Hushbee5/cold-gas-vertical-landing-rocket/figures/hardware/01_arac_genel.png

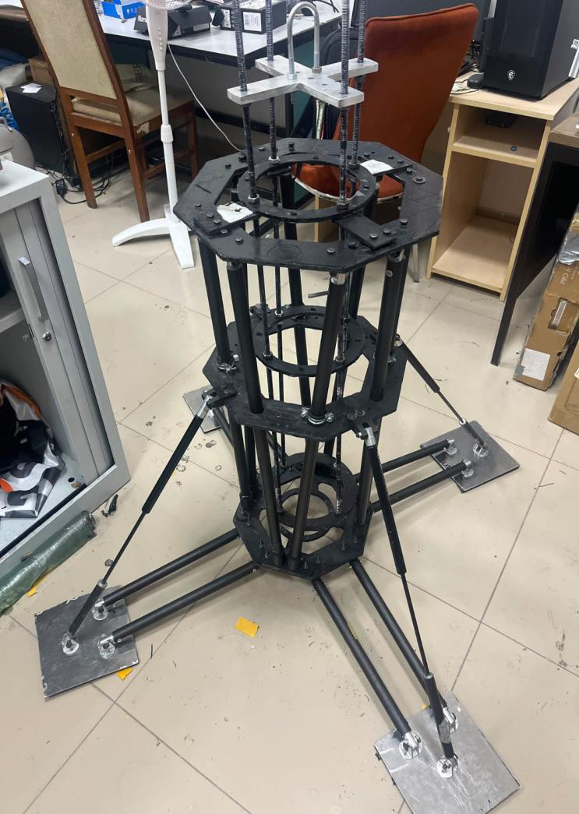
figures/hardware/01_arac_genel.png
