Hushbee5/cold-gas-vertical-landing-rocket/figures/hardware/02_sase.png

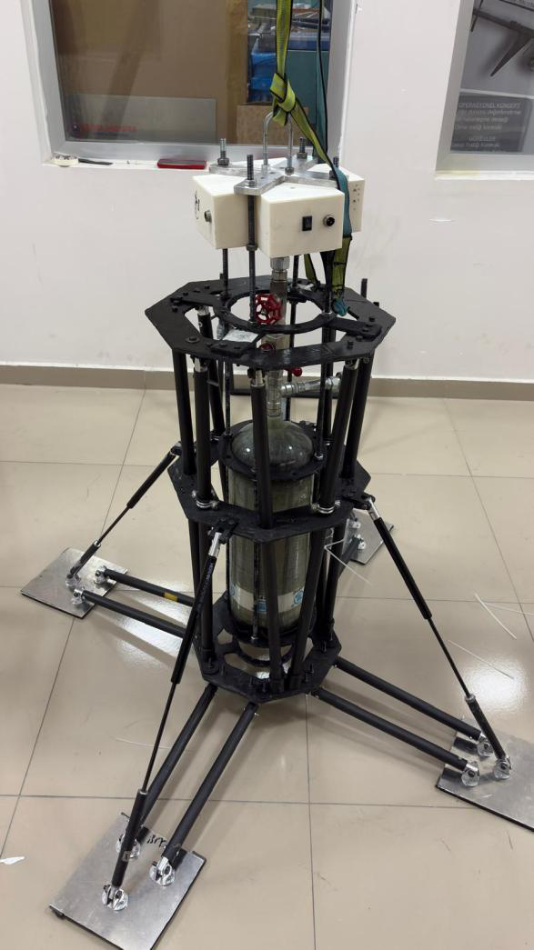
figures/hardware/02_sase.png
