Hushbee5/cold-gas-vertical-landing-rocket/figures/paper/18_bode.png

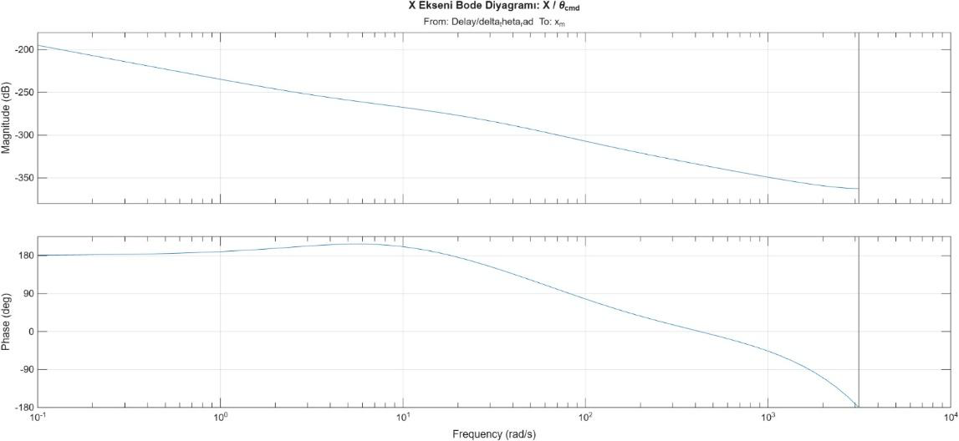
figures/paper/18_bode.png
