Hushbee5/cold-gas-vertical-landing-rocket/figures/paper/19_6dof_blok.png

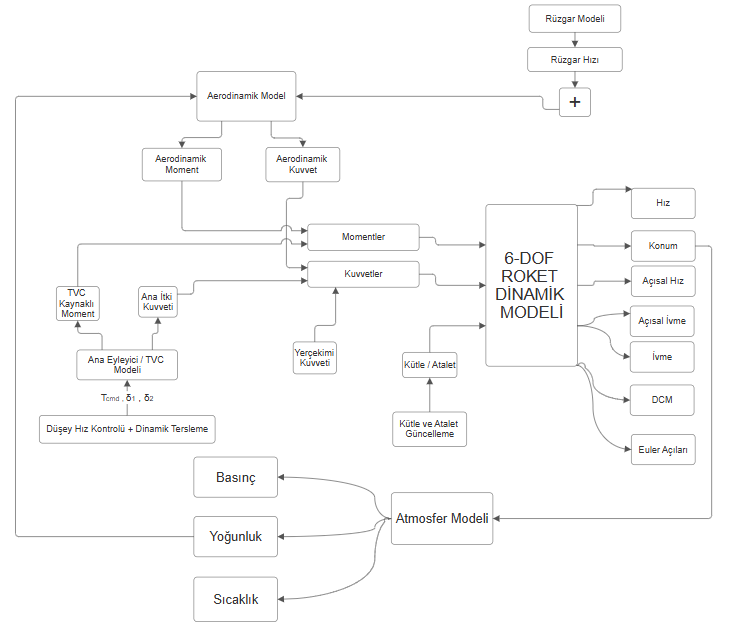
figures/paper/19_6dof_blok.png
