Hushbee5/cold-gas-vertical-landing-rocket/figures/paper/F07_dynamic_inversion.png

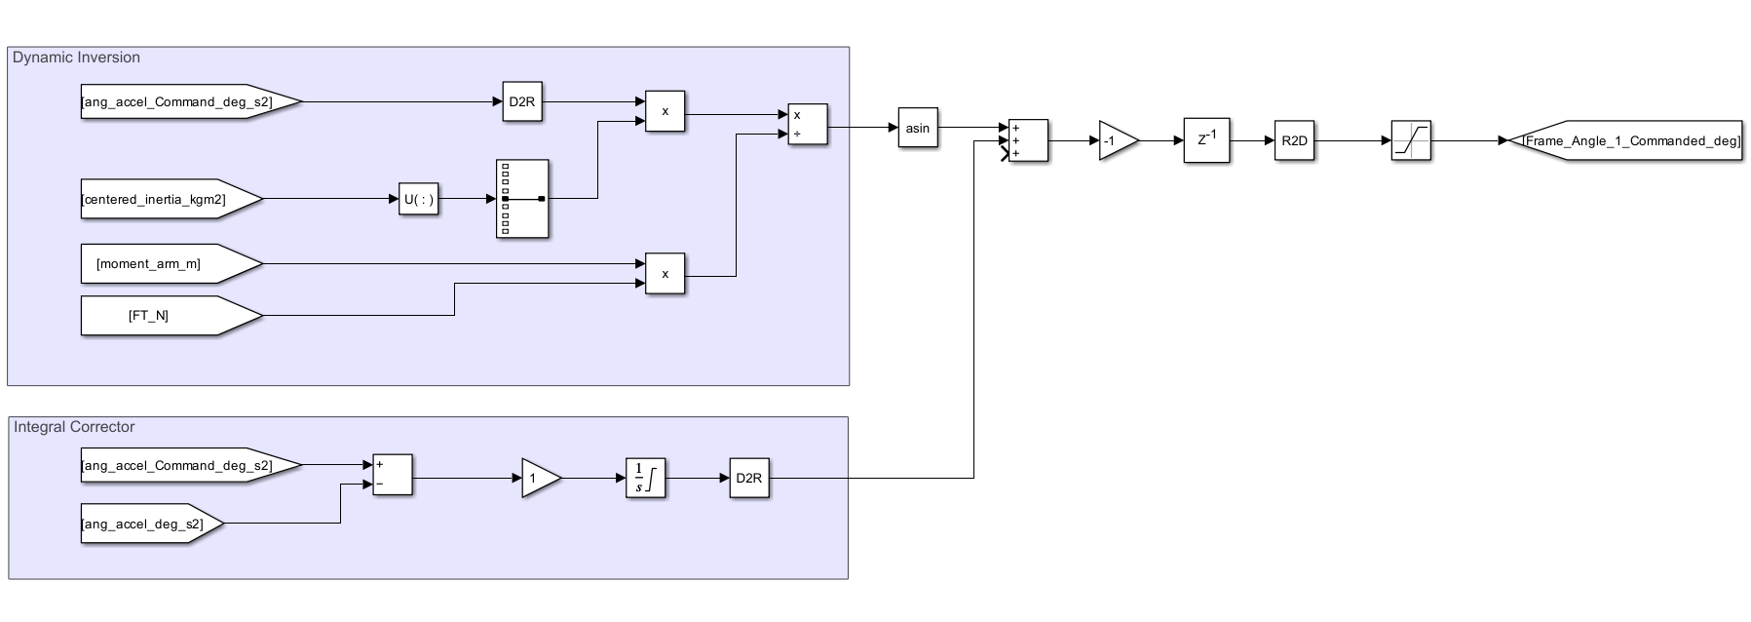
figures/paper/F07_dynamic_inversion.png
