Hushbee5/cold-gas-vertical-landing-rocket/figures/paper/F07_dynamic_inversion_hires.png

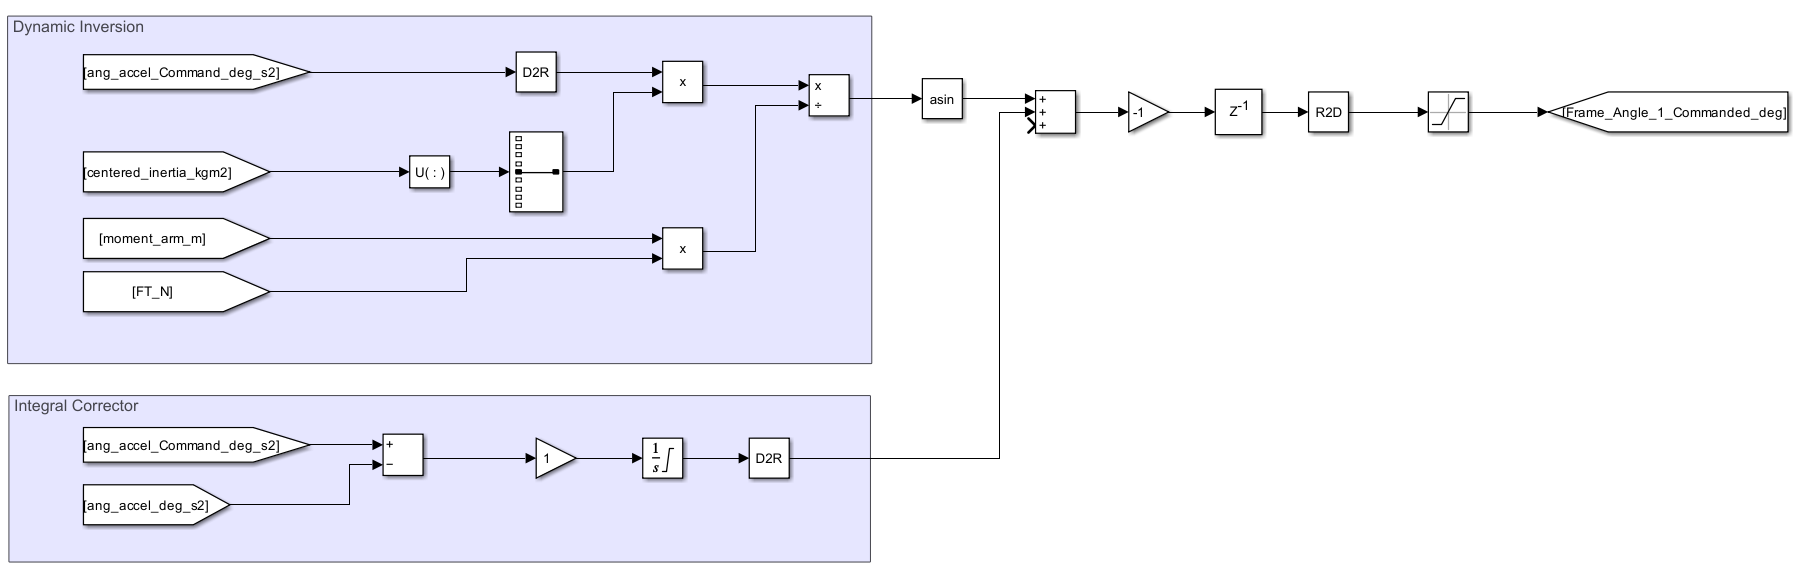
figures/paper/F07_dynamic_inversion_hires.png
