Hushbee5/cold-gas-vertical-landing-rocket/figures/paper/F_tethered_drop_telemetry.png

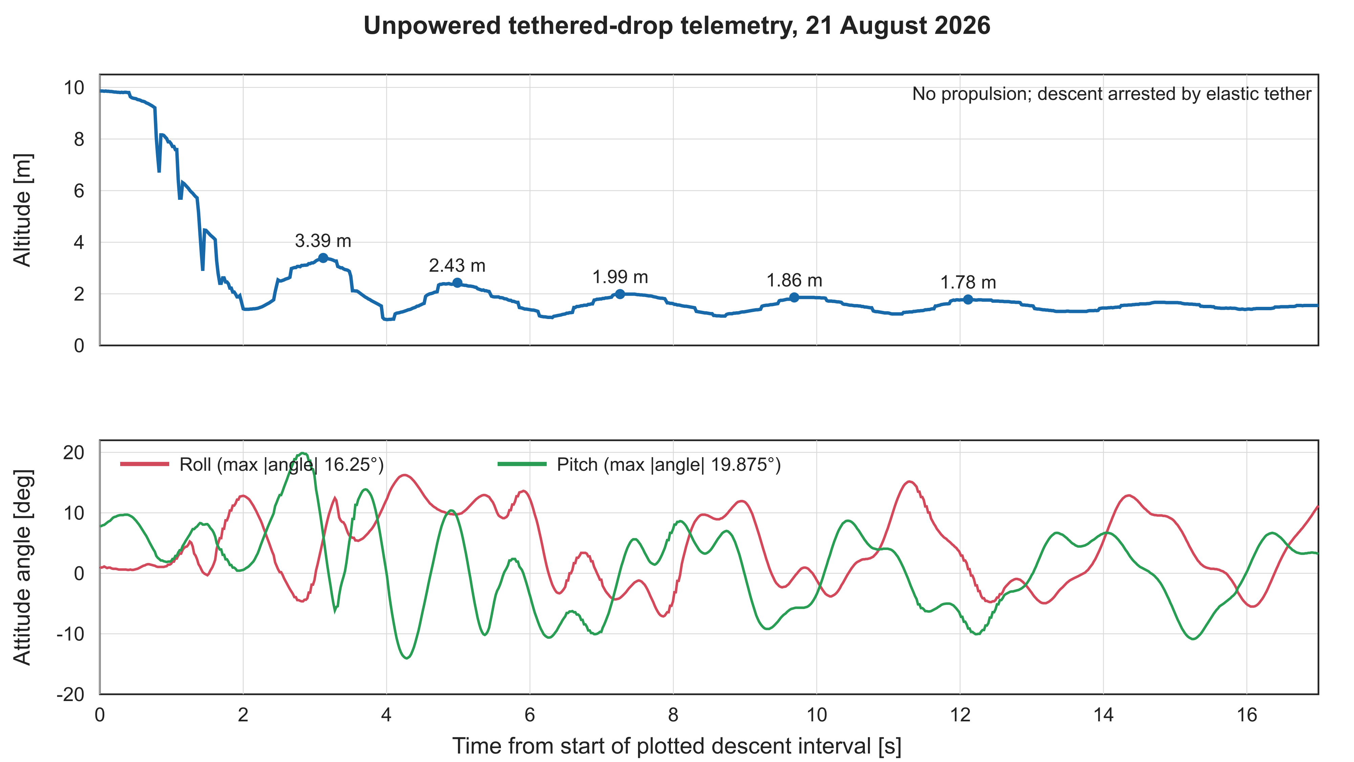
figures/paper/F_tethered_drop_telemetry.png
