Hushbee5/cold-gas-vertical-landing-rocket/figures/paper/fusion_bench_source.png

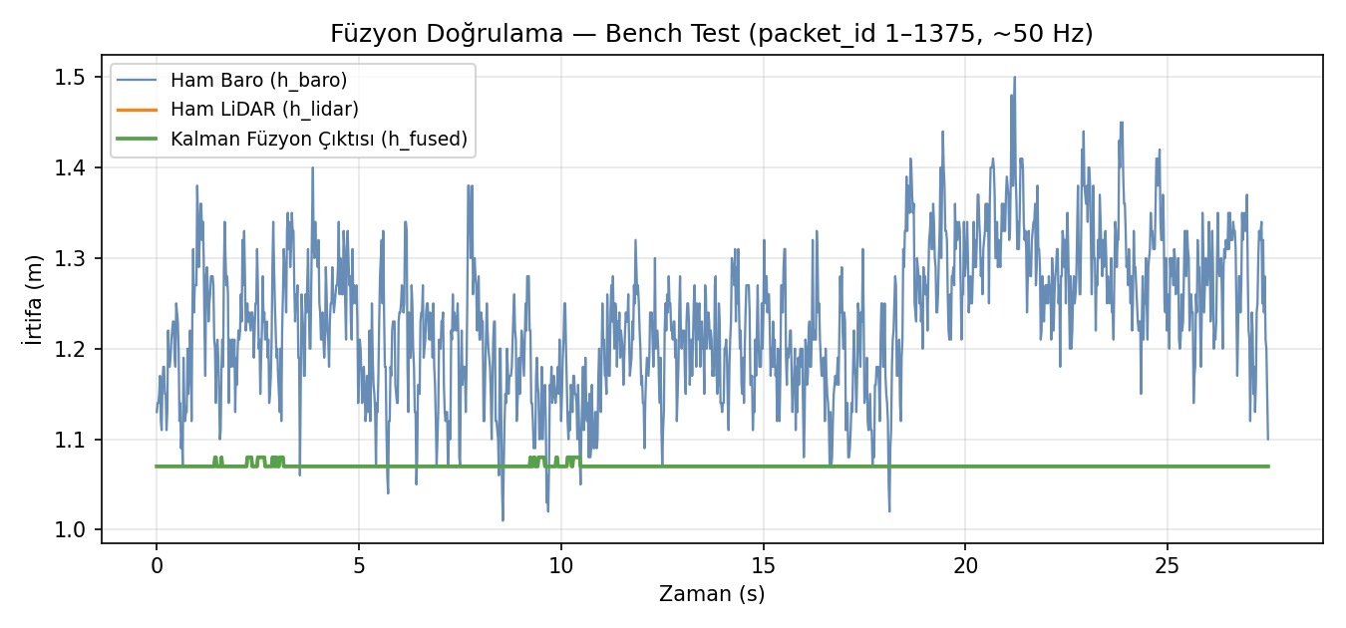
figures/paper/fusion_bench_source.png
