Hushbee5/cold-gas-vertical-landing-rocket/figures/simulink/SL_actflow_1.png

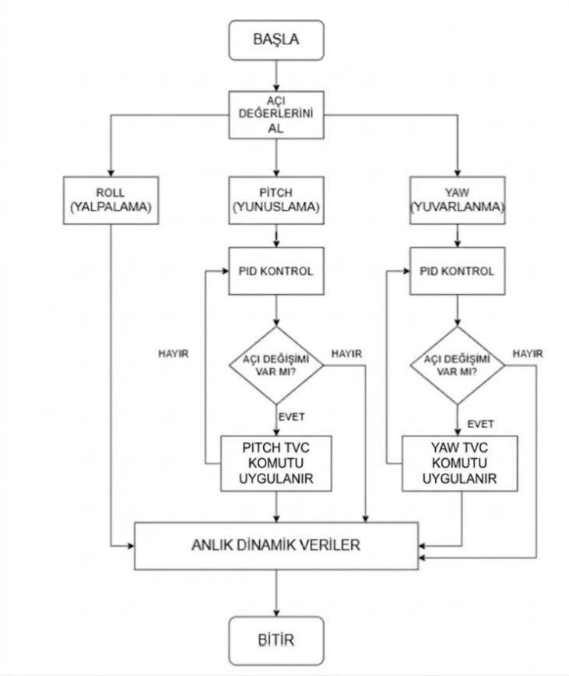
figures/simulink/SL_actflow_1.png
