Hushbee5/cold-gas-vertical-landing-rocket/figures/simulink/SL_chirp_2.png

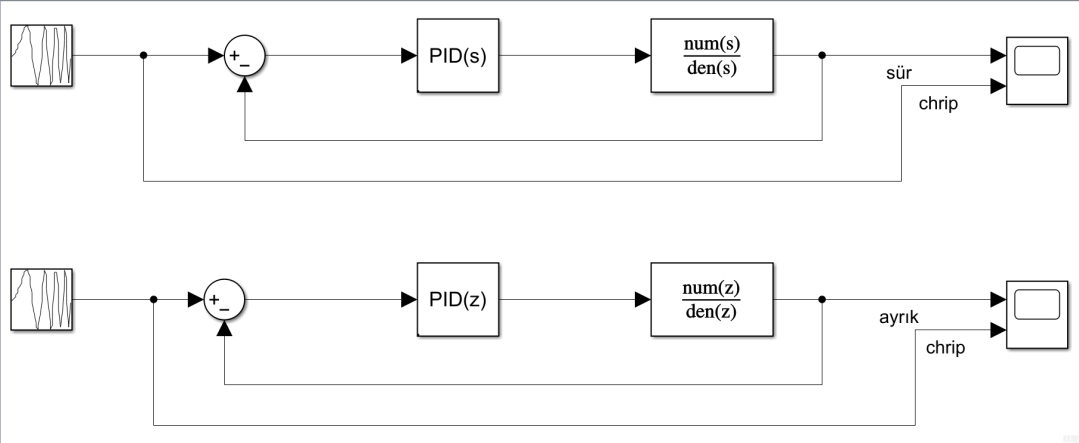
figures/simulink/SL_chirp_2.png
