Hushbee5/cold-gas-vertical-landing-rocket/figures/simulink/SL_p24_2.png

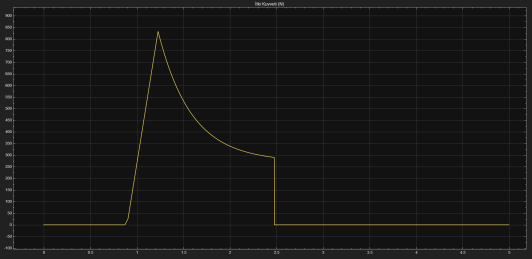
figures/simulink/SL_p24_2.png
