Hushbee5/cold-gas-vertical-landing-rocket/figures/simulink_models/hil_02_plant.png

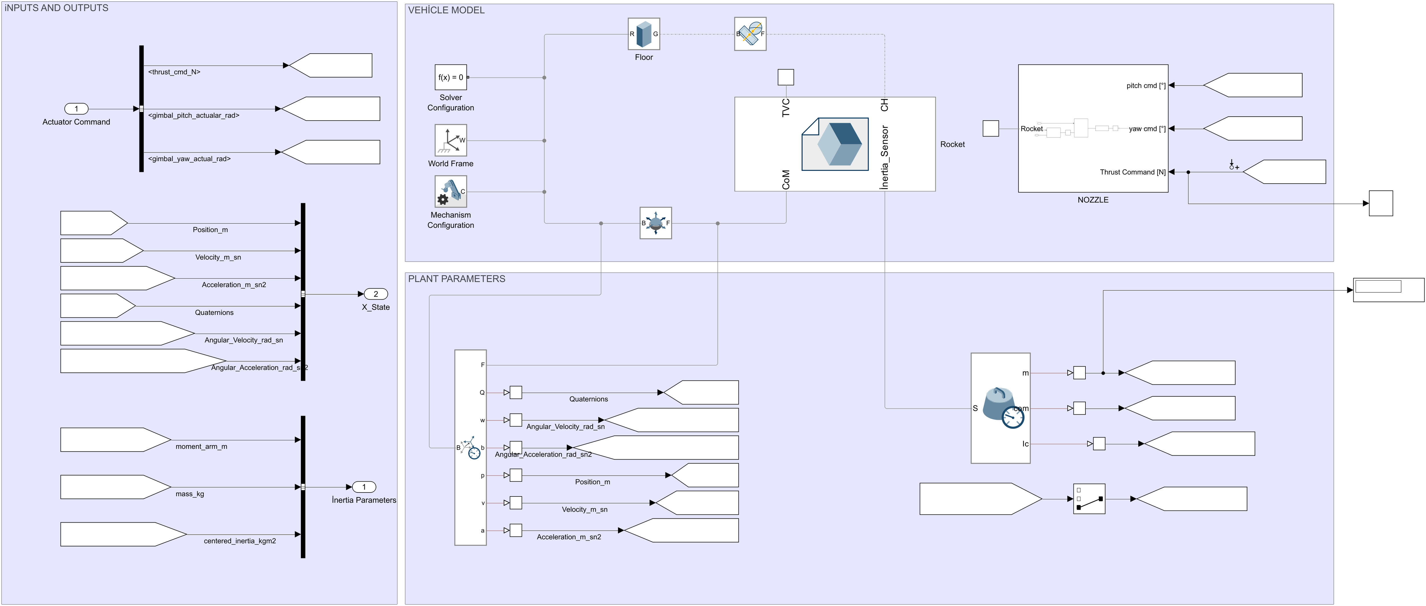
figures/simulink_models/hil_02_plant.png
