Hushbee5/cold-gas-vertical-landing-rocket/figures/simulink_models/hil_03_simscape_model_top.png

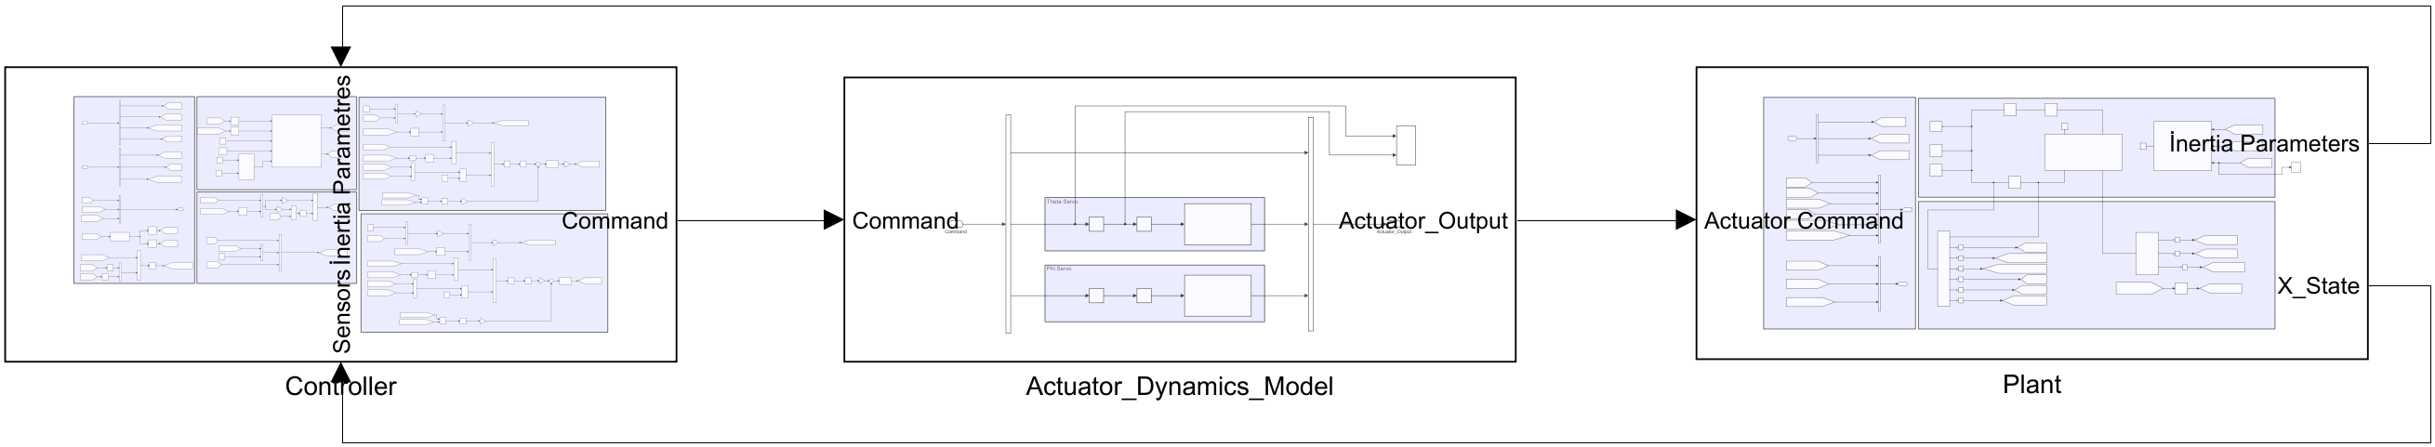
figures/simulink_models/hil_03_simscape_model_top.png
