Hushbee5/cold-gas-vertical-landing-rocket/figures/simulink_models/hil_04_simscape_controller.png

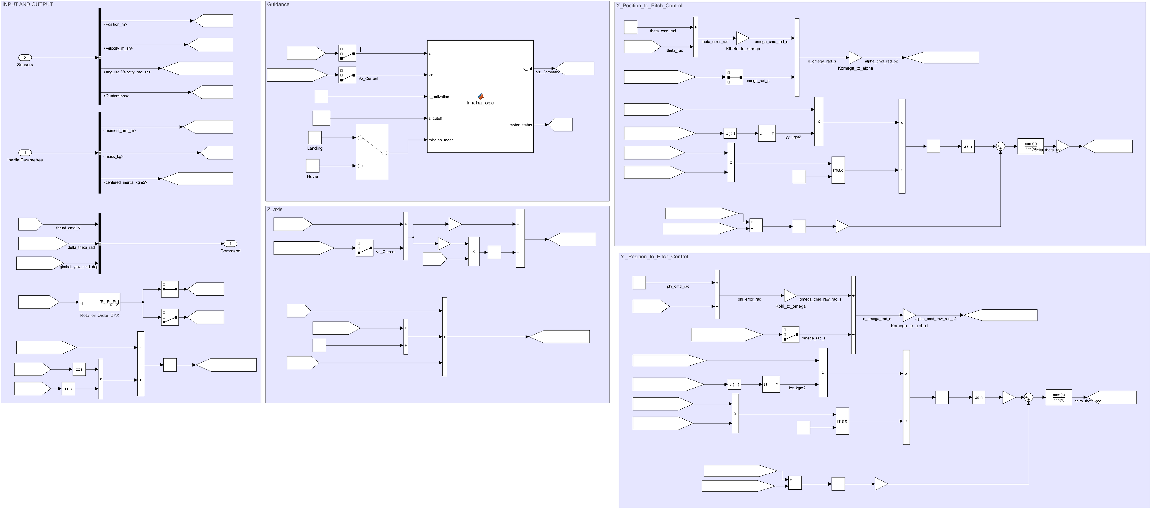
figures/simulink_models/hil_04_simscape_controller.png
