Hushbee5/cold-gas-vertical-landing-rocket/figures/simulink_models/ktr_6dof_01_landing_scenario.png

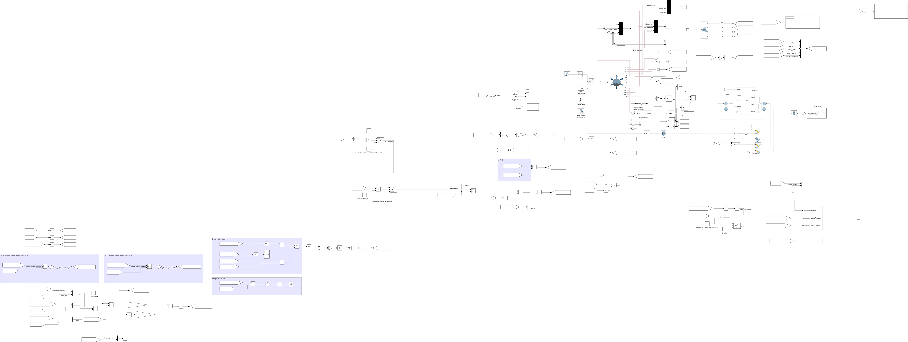
figures/simulink_models/ktr_6dof_01_landing_scenario.png
