Hushbee5/cold-gas-vertical-landing-rocket/figures/simulink_models/ktr_6dof_02_variable_gas_mass.png

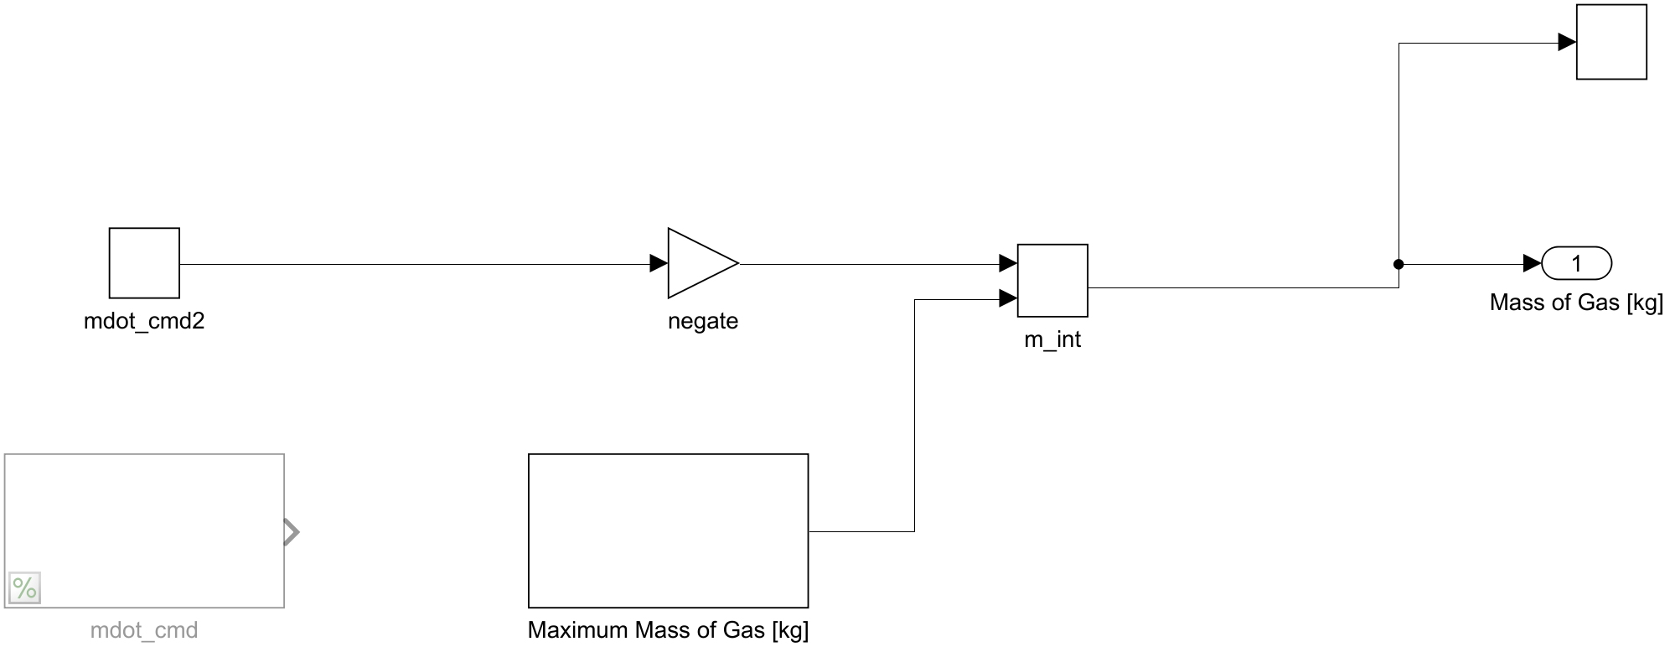
figures/simulink_models/ktr_6dof_02_variable_gas_mass.png
