Hushbee5/cold-gas-vertical-landing-rocket/figures/simulink_models/ndi_6dof_01_top_level.png

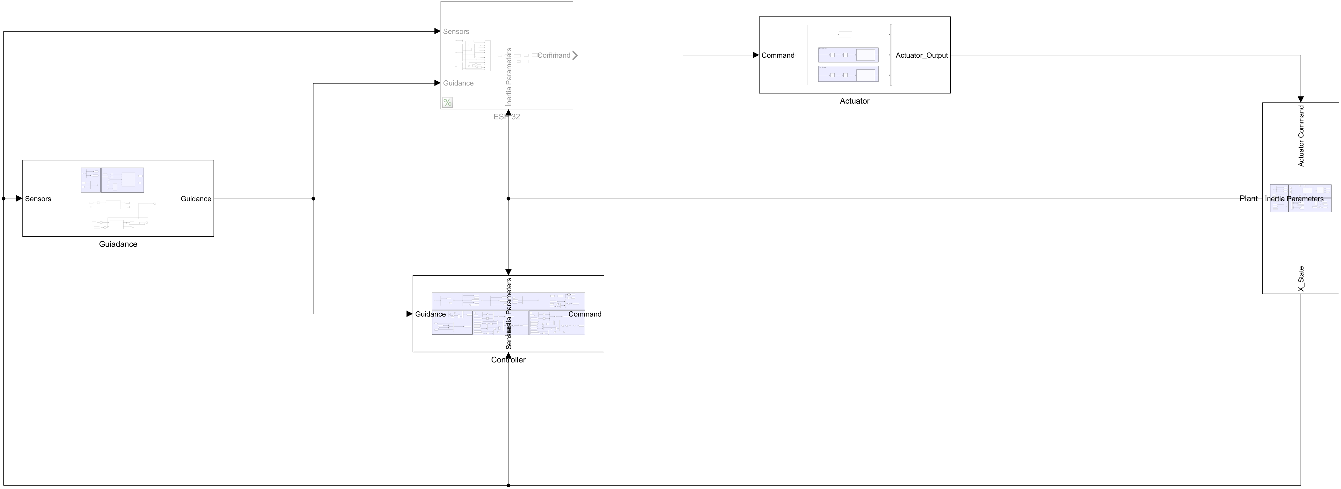
figures/simulink_models/ndi_6dof_01_top_level.png
