Hushbee5/cold-gas-vertical-landing-rocket/figures/simulink_models/ndi_6dof_02_actuator_servo_dynamics.png

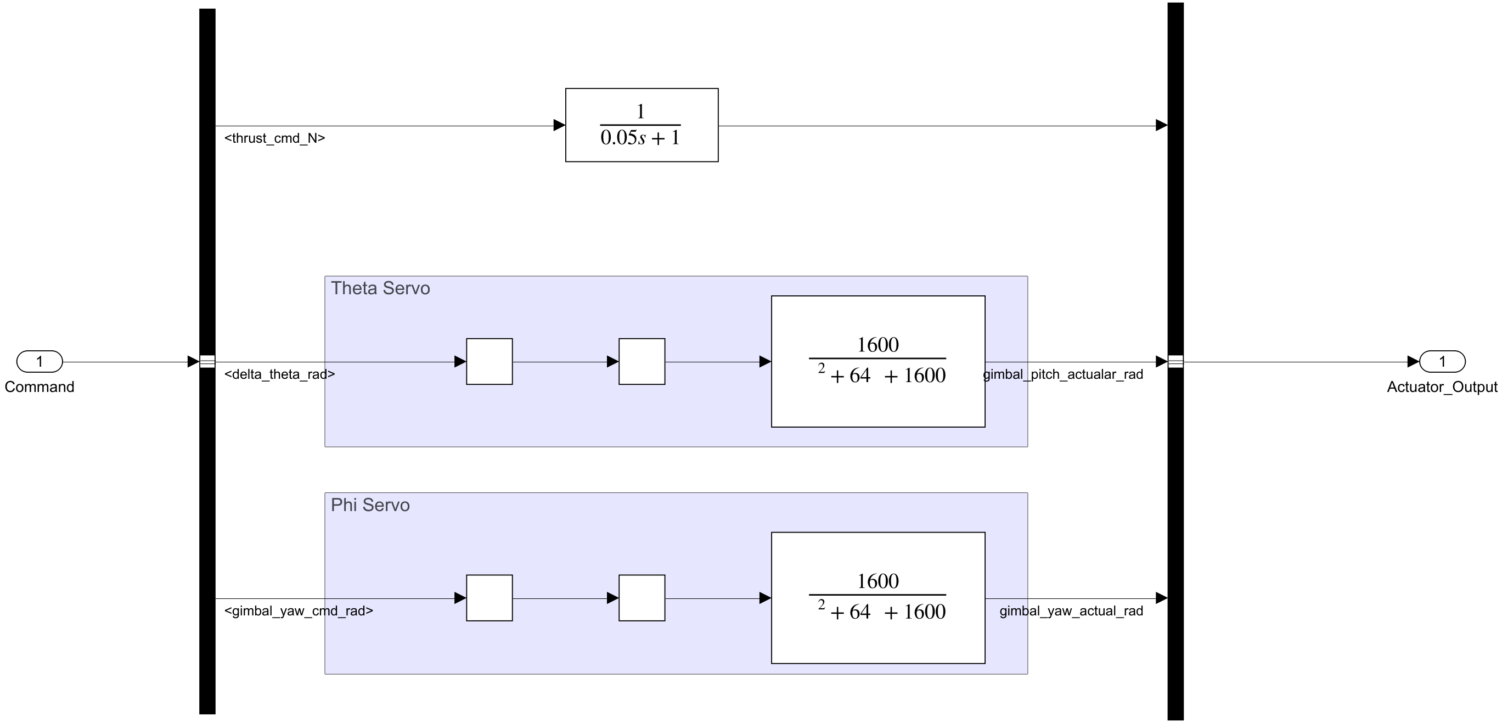
figures/simulink_models/ndi_6dof_02_actuator_servo_dynamics.png
