Hushbee5/cold-gas-vertical-landing-rocket/figures/simulink_models/ndi_6dof_03_controller_ndi_and_vertical.png

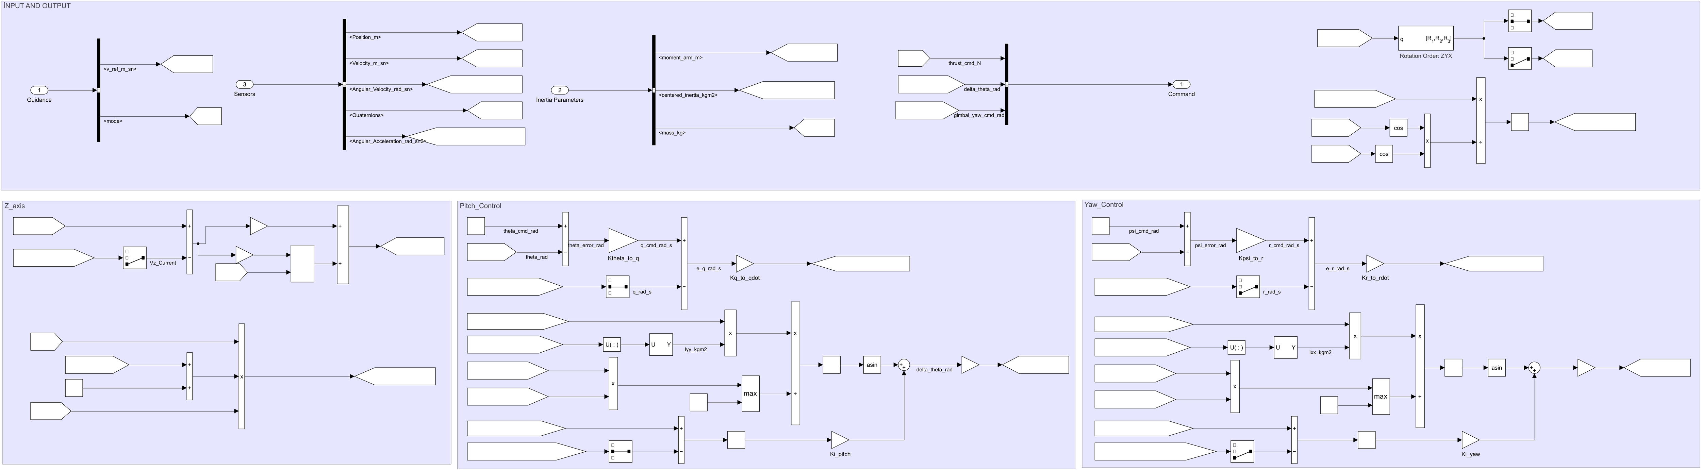
figures/simulink_models/ndi_6dof_03_controller_ndi_and_vertical.png
