Hushbee5/cold-gas-vertical-landing-rocket/figures/simulink_models/ndi_6dof_04_guidance.png

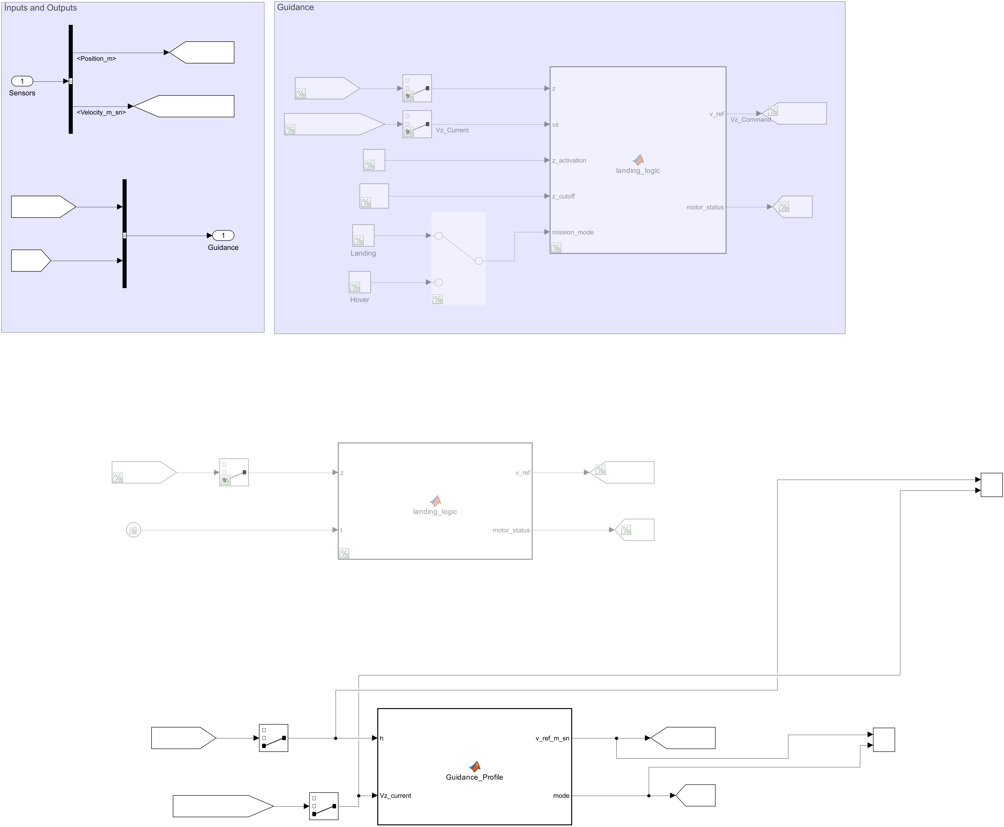
figures/simulink_models/ndi_6dof_04_guidance.png
