Hushbee5/cold-gas-vertical-landing-rocket/figures/simulink_models/ndi_6dof_05_plant_simscape_multibody.png

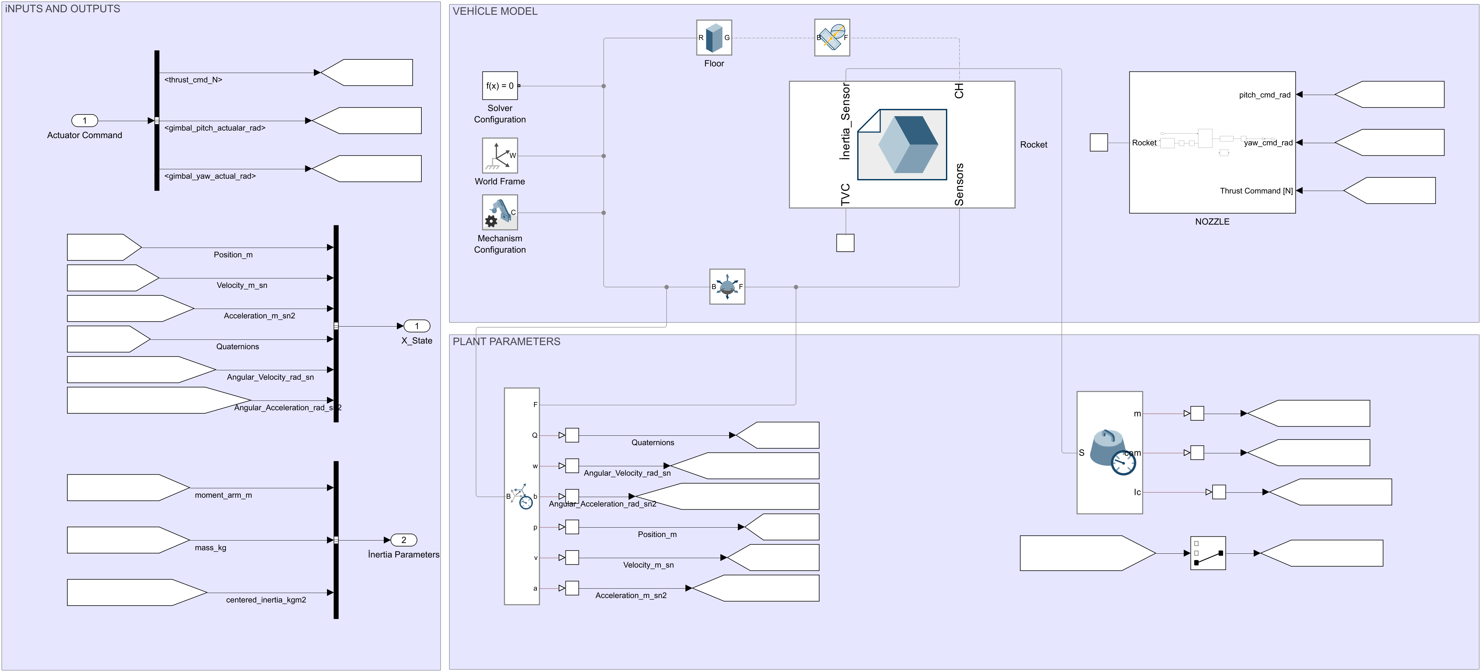
figures/simulink_models/ndi_6dof_05_plant_simscape_multibody.png
