Hushbee5/cold-gas-vertical-landing-rocket/figures/simulink_models/ndi_6dof_06_nozzle_tvc_gimbal.png

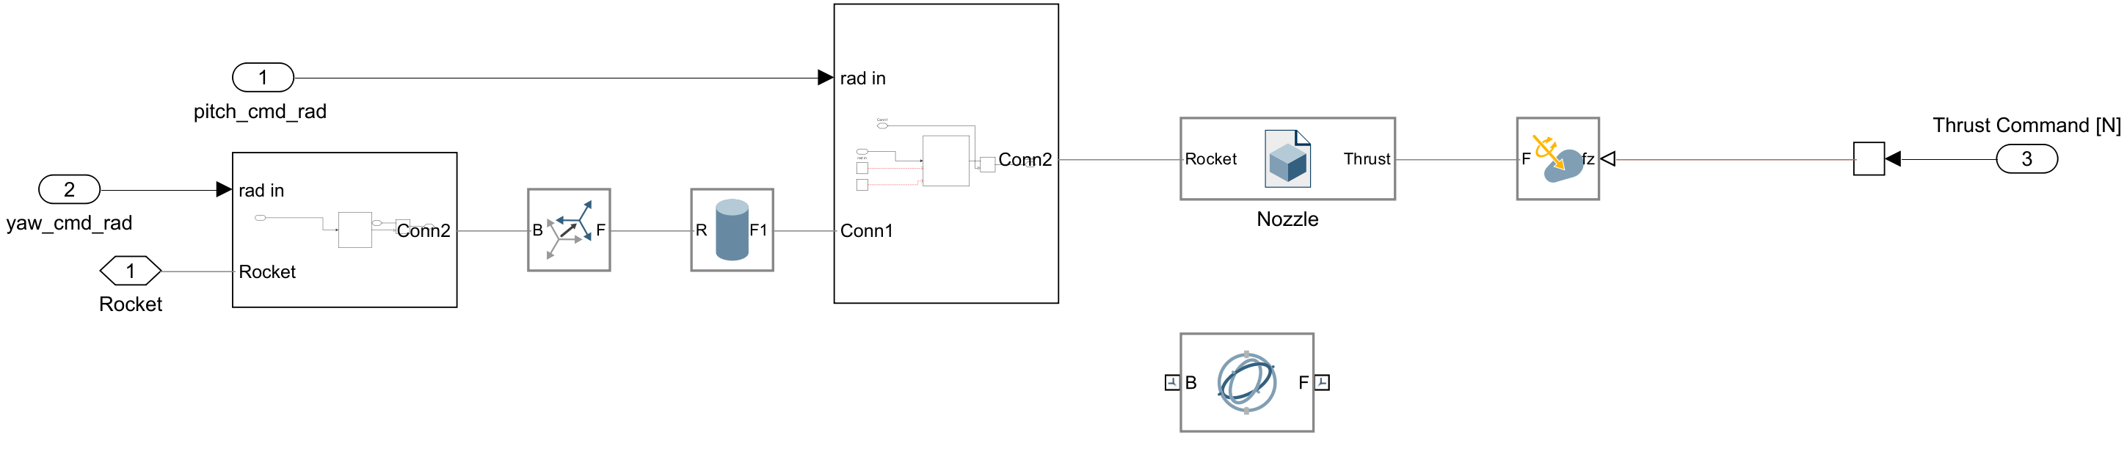
figures/simulink_models/ndi_6dof_06_nozzle_tvc_gimbal.png
