Hushbee5/cold-gas-vertical-landing-rocket/hil/hover/hover_1_irtifa.png

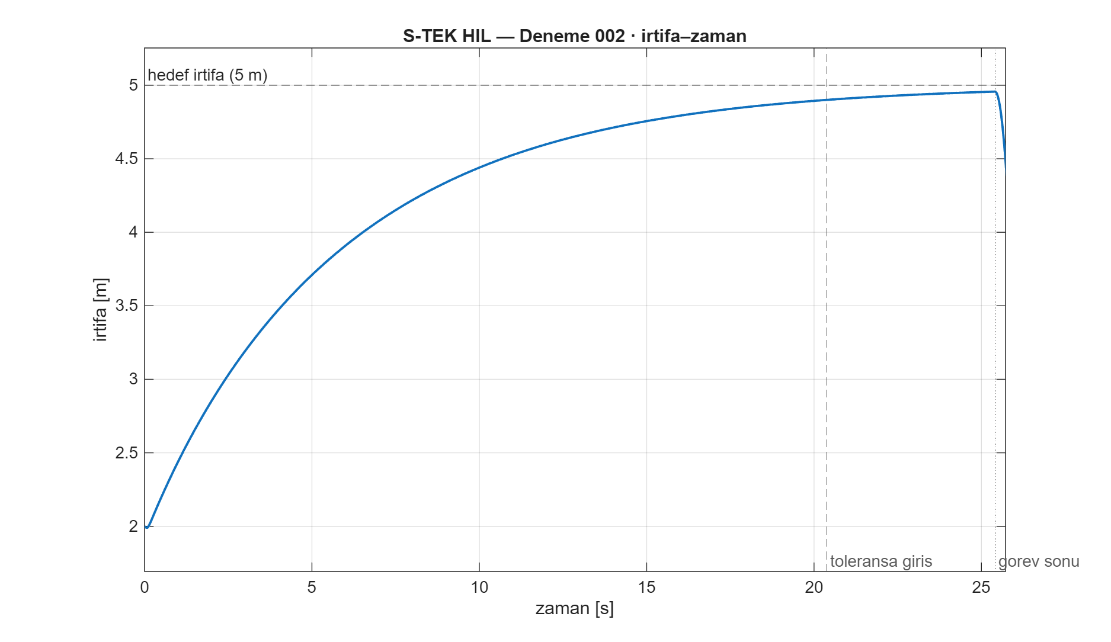
hil/hover/hover_1_irtifa.png
