Hushbee5/cold-gas-vertical-landing-rocket/hil/hover/hover_2_hiz_referans.png

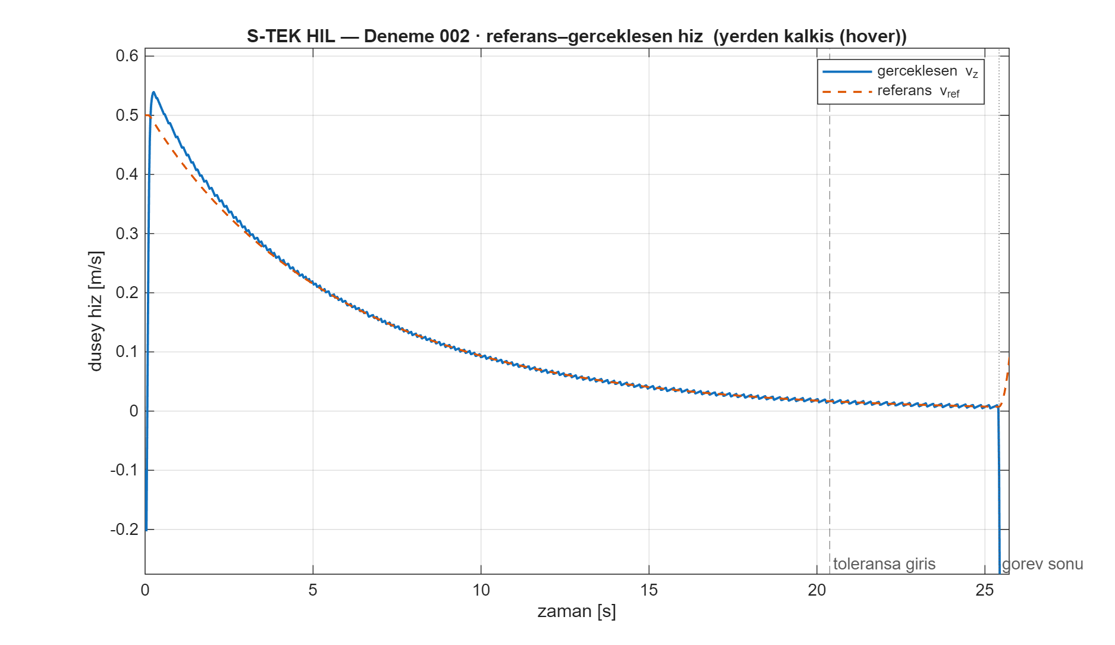
hil/hover/hover_2_hiz_referans.png
