Hushbee5/cold-gas-vertical-landing-rocket/hil/hover/hover_3_ivme.png

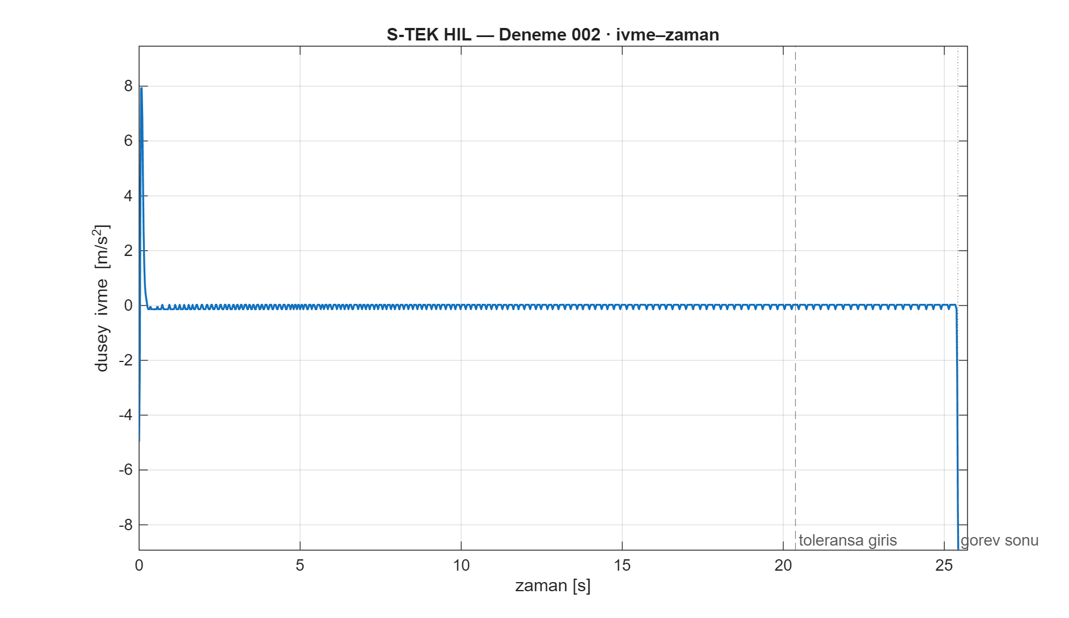
hil/hover/hover_3_ivme.png
