Hushbee5/cold-gas-vertical-landing-rocket/hil/hover/hover_4_euler.png

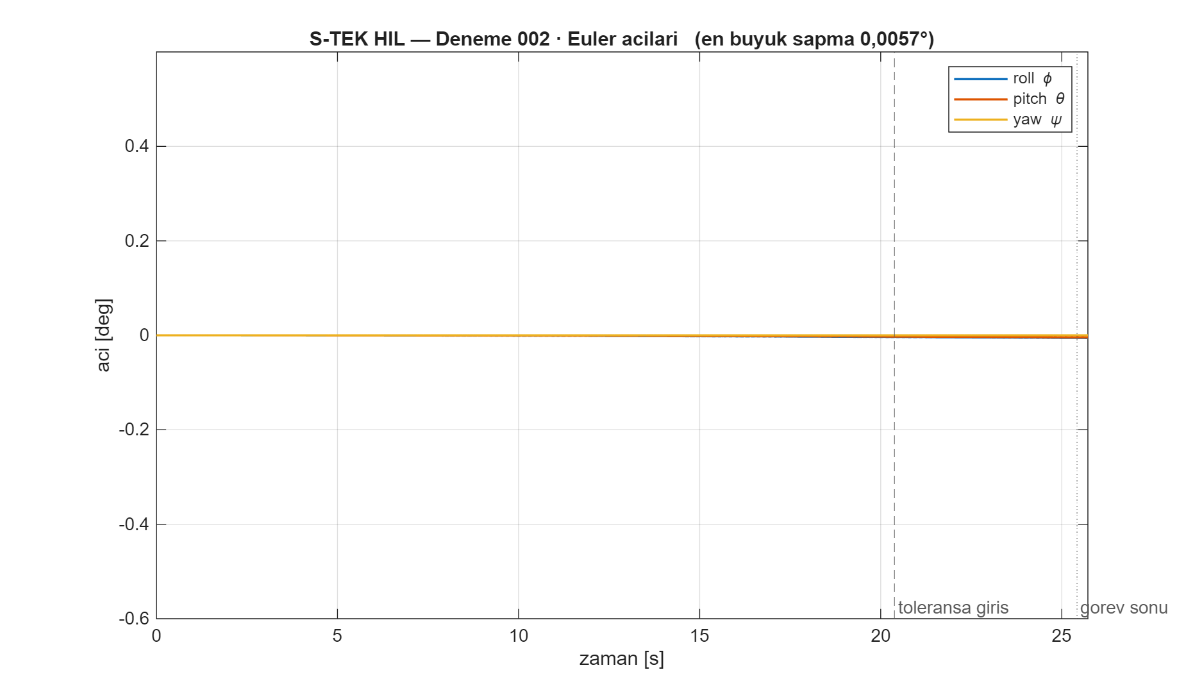
hil/hover/hover_4_euler.png
