Hushbee5/cold-gas-vertical-landing-rocket/hil/hover/hover_5_pqr.png

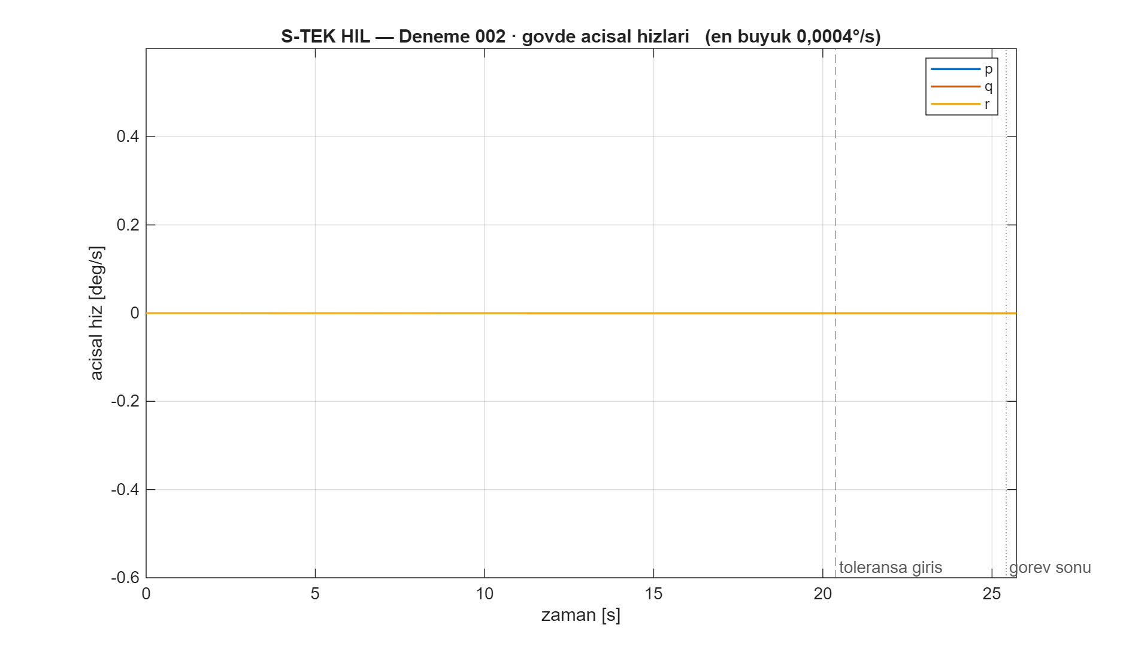
hil/hover/hover_5_pqr.png
