Hushbee5/cold-gas-vertical-landing-rocket/hil/hover/hover_6_itki.png

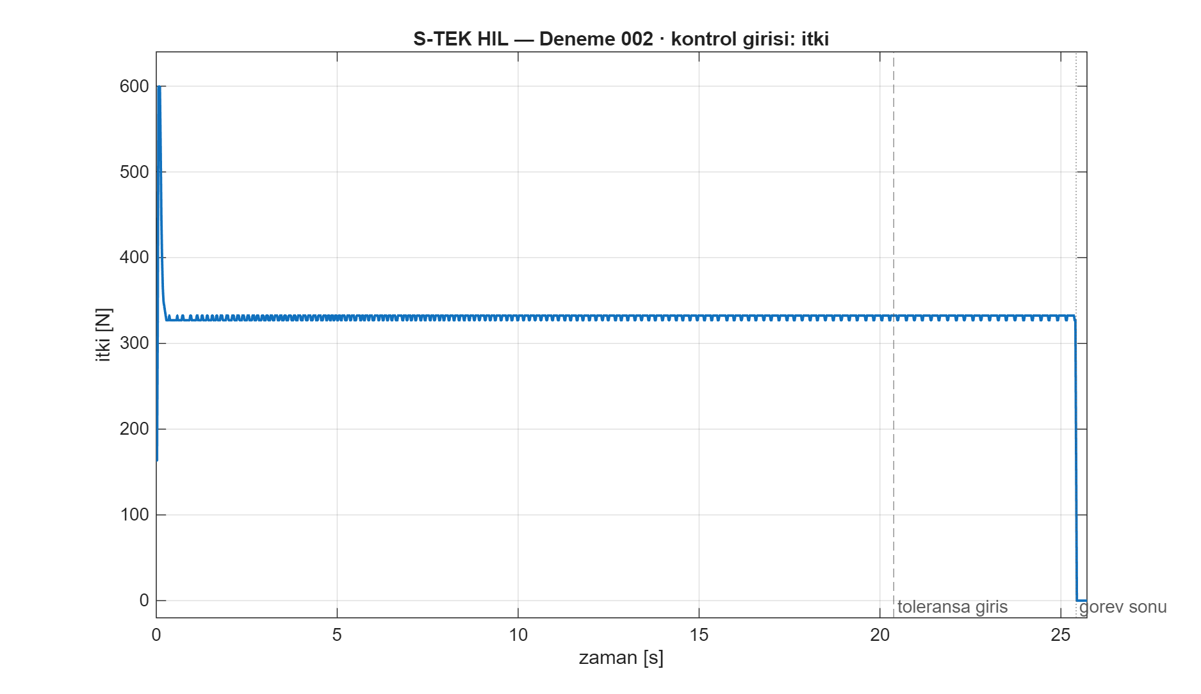
hil/hover/hover_6_itki.png
