Hushbee5/cold-gas-vertical-landing-rocket/hil/hover/hover_8_vana_paket.png

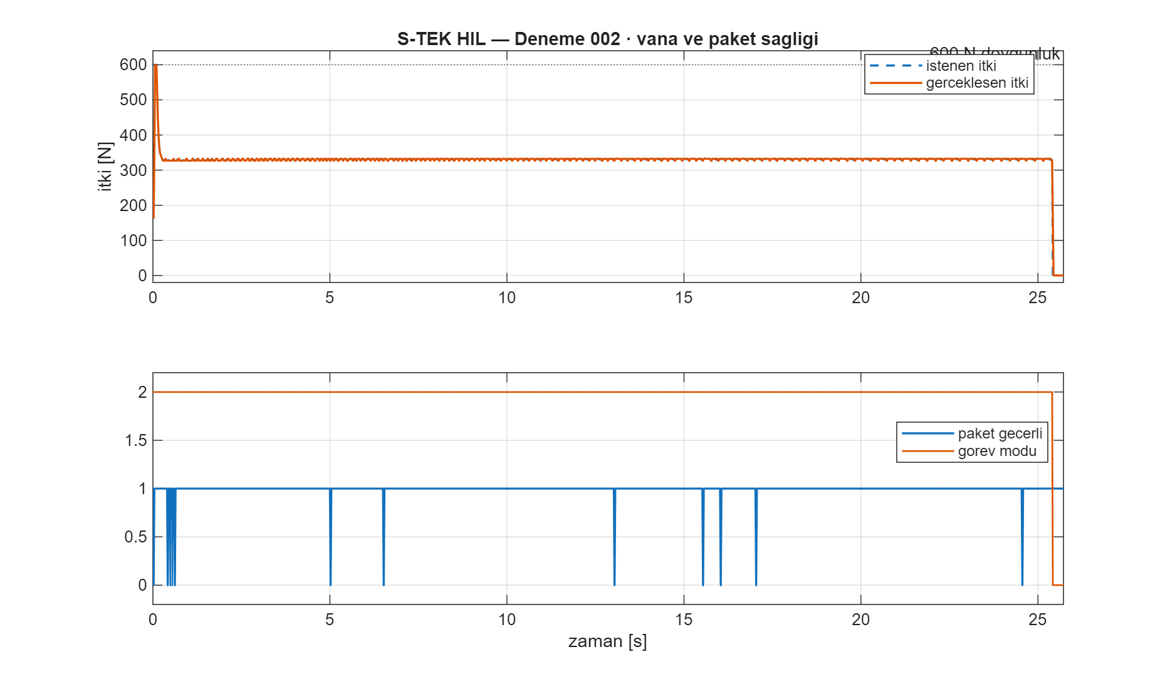
hil/hover/hover_8_vana_paket.png
