Hushbee5/cold-gas-vertical-landing-rocket/hil/landing/deneme001_1_irtifa.png

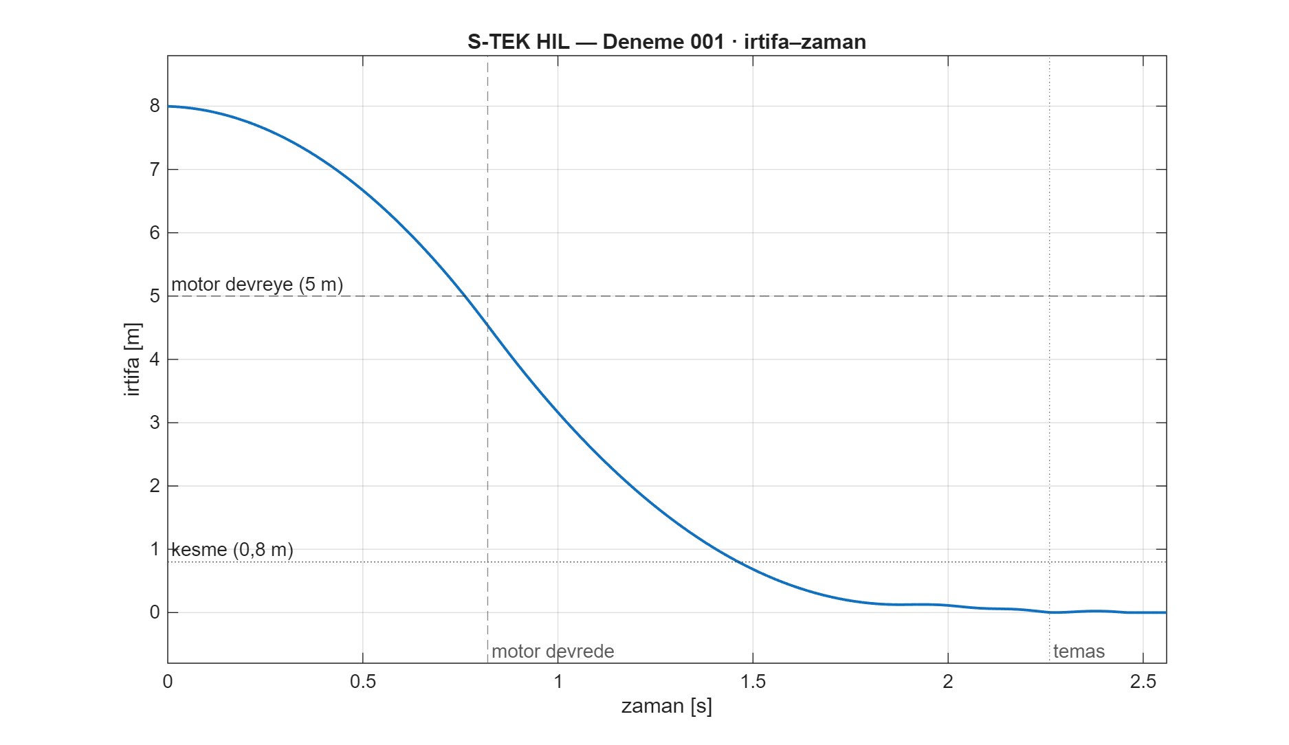
hil/landing/deneme001_1_irtifa.png
