Hushbee5/cold-gas-vertical-landing-rocket/hil/landing/deneme001_2_hiz_referans.png

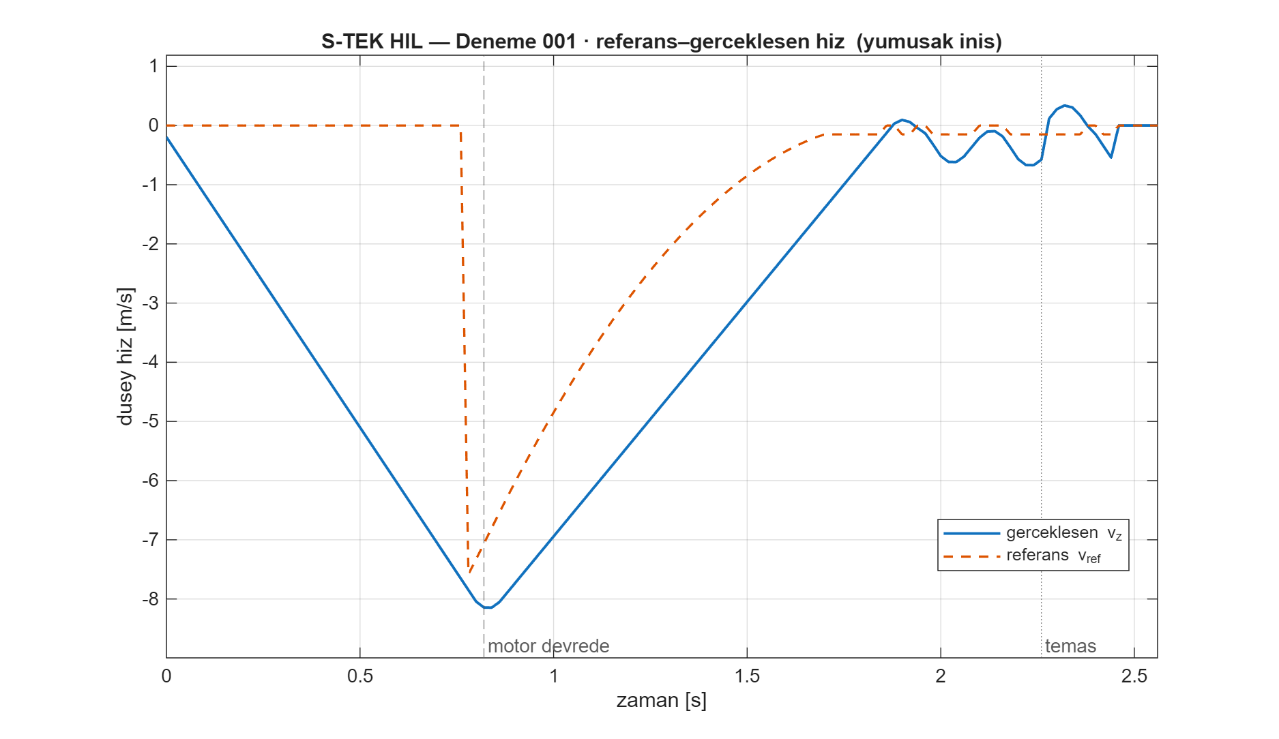
hil/landing/deneme001_2_hiz_referans.png
