Hushbee5/cold-gas-vertical-landing-rocket/hil/landing/deneme001_3_ivme.png

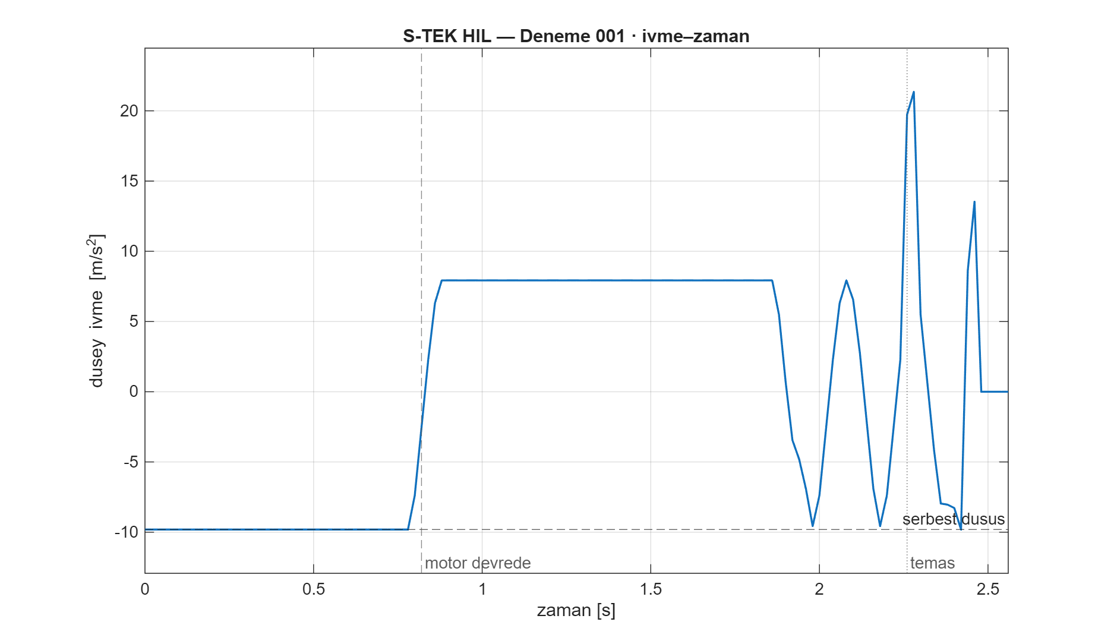
hil/landing/deneme001_3_ivme.png
