Hushbee5/cold-gas-vertical-landing-rocket/hil/landing/deneme001_4_euler.png

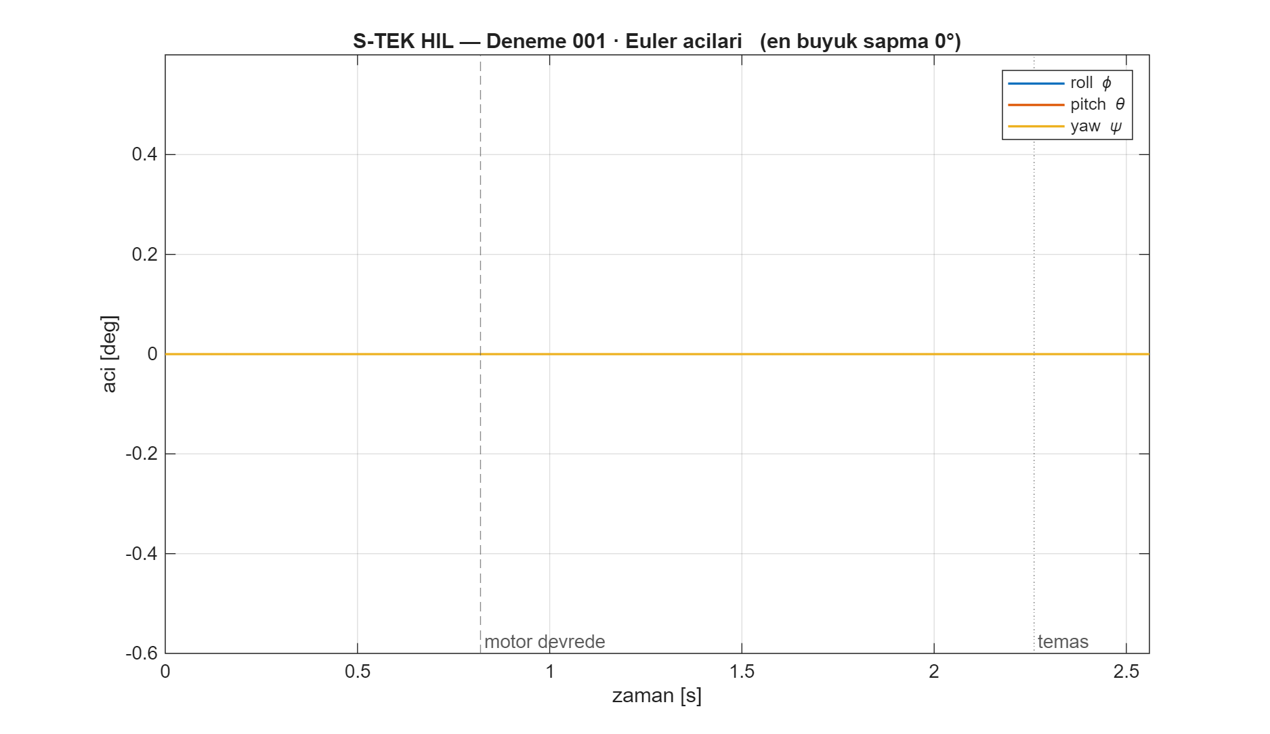
hil/landing/deneme001_4_euler.png
