Hushbee5/cold-gas-vertical-landing-rocket/hil/landing/deneme001_6_itki.png

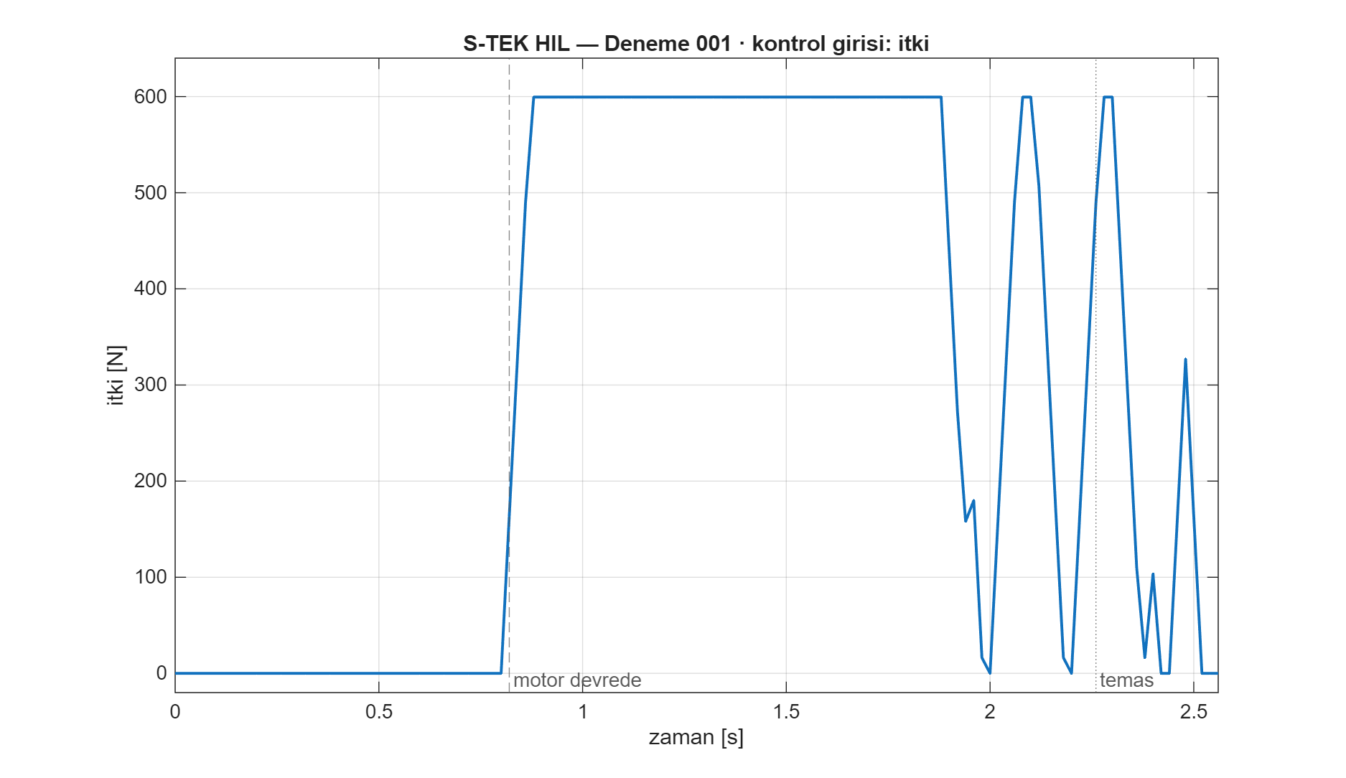
hil/landing/deneme001_6_itki.png
