Hushbee5/cold-gas-vertical-landing-rocket/hil/landing/deneme001_7_lule.png

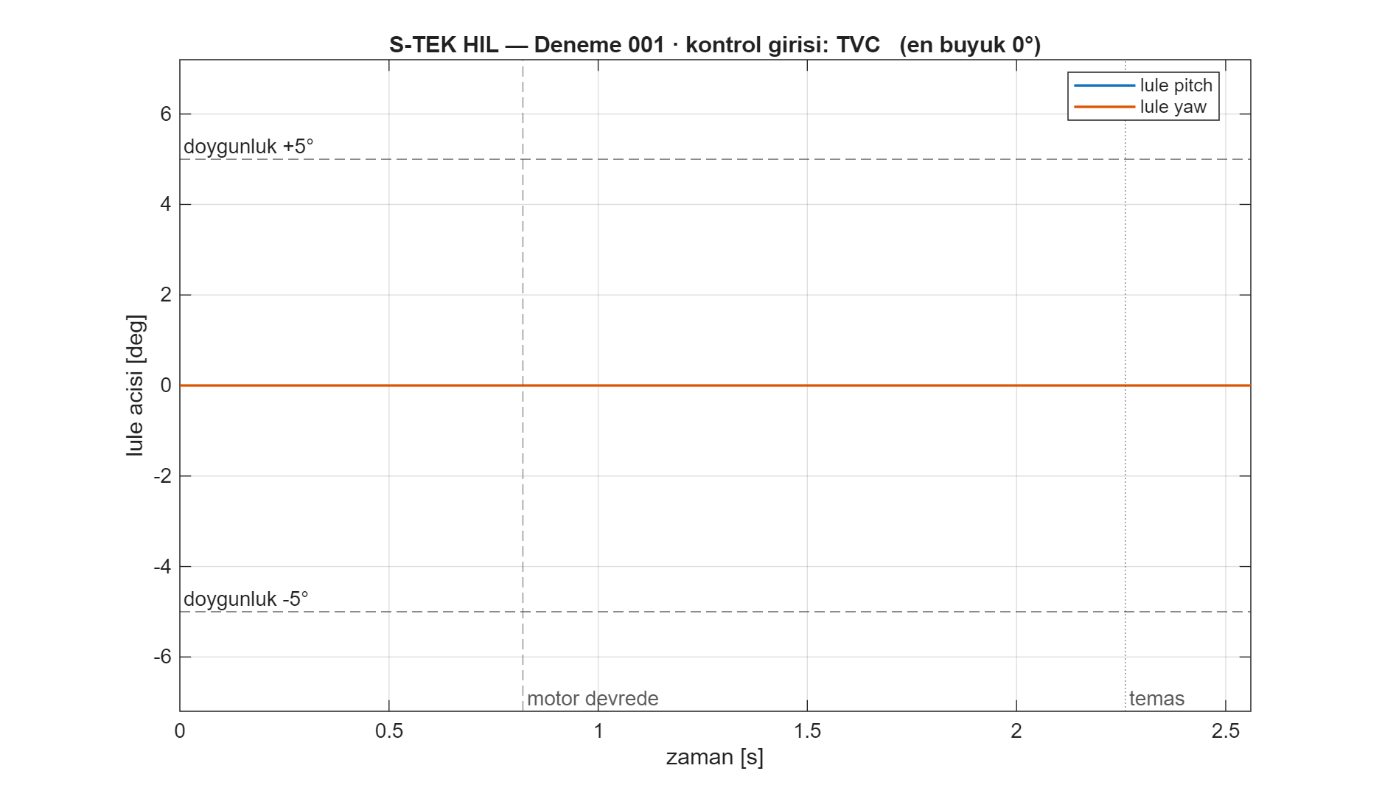
hil/landing/deneme001_7_lule.png
