Hushbee5/cold-gas-vertical-landing-rocket/hil/landing/deneme001_8_vana_paket.png

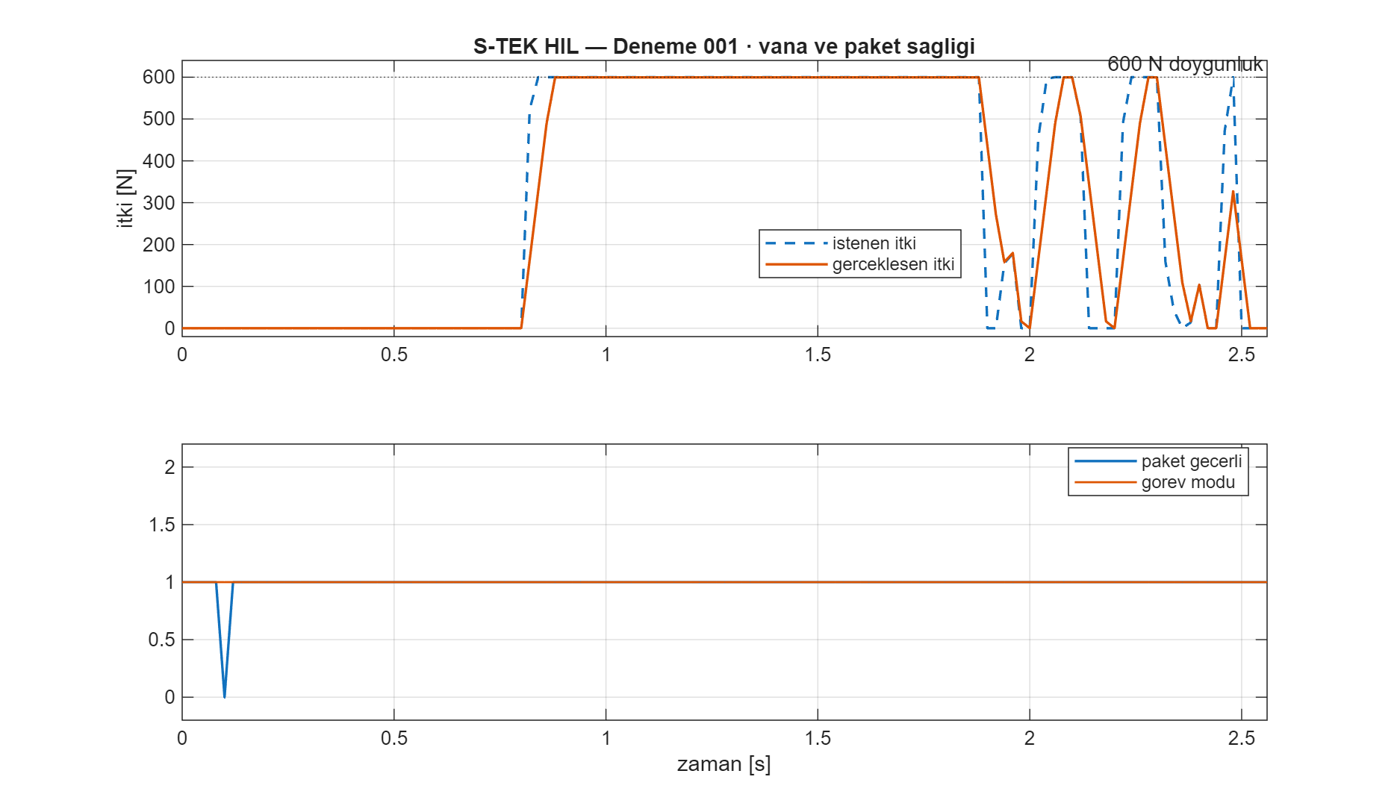
hil/landing/deneme001_8_vana_paket.png
