Hushbee5/cold-gas-vertical-landing-rocket/data/bom/bill_of_materials.xlsx

No. | Bileşen Adı | Adet | Fiyat (TL) | Tedarikçi | Tedarik | Link | Kullanılacak Alt | Açıklama
1 | BNO055 | 1 | 2.439,43 TL | e komponent | 7-10 iş günü | https://www.e-komponent.com/adafruit-2472-9-dof-absolute-orientation-imu-fusion-breakout | Aviyonik
2 | Dsservo DS5160 | 2 | 1637.42 | Robocombo | 7-10 iş günü | https://www.robocombo.com/dsservo-ds5160-60kg-servo-motor-180-derece-su--4147 | Aviyonik
3 | 11.1 V 3S Lipo Pil-Batarya 1800 mAh 65C | 1 | 2.371,89 TL | Robotistan | 7-10 iş günü | https://www.robotistan.com/111v-3s-lipo-pil-1800mah-65c | Aviyonik
4 | Hobbywing 30606000 UBEC, 25 Amper, HV, 3-18S LiPo | 1 | 5613.75 | hobbytime | 7-10 iş günü | https://www.hobbytime.com.tr/hobbywing-30606000-ubec-25-amper-3-18s-lipo-19039 | Aviyonik
5 | Akü Devre Kesici Şalter 12V-60V 600A Büyük MT-ADK600 | 2.00 | 1.415,40 TL | adam | 7-10 iş günü | https://www.adamoto.com.tr/urun/aku-devre-kesici-salter-12v-60v-600a-buyuk-1044 | Aviyonik
6 | Missile Switch - Kırmızı Kapaklı On-Off Anahtar | 3 | 112,22 TL | robotistan | 7-10 iş günü | https://www.robotistan.com/missile-switch-kapakli-on-off-anahtar | Aviyonik
7 | BMP390 Barometrik Basınç ve Isı Sensörü | 2 | 559,80 ₺ | robocombo | 7-10 iş günü | https://www.robocombo.com/bmp390-barometrik-basinc-ve-isi-sensoru-4327 | Aviyonik
6 | TFmini Plus Laser Distance Sensor | 1 | 4.114,96 TL | Motorobit | 7-10 iş günü | https://www.robotsepeti.com/tfmini-plus-mikro-lidar-modulu | Aviyonik
7 | ESP32-S3-DevKitC-1-N8R8 | 3 | 1.069,69 TL | Empa Elektronik | 7-10 iş günü | https://empa.com/esp32-s3-devkitc-1-n8r8-wi-fi-bluetooth-gelistirme-kiti | Aviyonik
8 | LM2596 REGÜLATÖR | 5 | 163,10 TL | Özdisan | 7-10 iş günü | https://www.ozdisan.com/p/moduller-870/ozd-arduino-lm2596-adj-dc-dc-s-down-1575400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 | Aviyonik
9 | XT90-S Anti Spark Erkek-Dişi Konnektör Takımı | 2 | 230,40 TL | Motorobit | 7-10 iş günü | https://www.motorobit.com/xt90-s-anti-spark-erkek-disi-konnektor-takimi | Aviyonik
10 | 22,2V 6S 1800mAh 65C Lipo Batarya | 3 | 3.803,05 TL | Motorobit | 7-10 iş günü | https://www.motorobit.com/222v-6s-1800mah-65c-lipo-batarya | Aviyonik
11 | Cs-D808 enkoderli step motor sürücü | 1 | 5.556,00 TL | Sankaya Mekatronik | 7-10 iş günü | https://www.otomasyoncu.net/urun/cs-d808-leadshine-enkoderli-step-motor-surucusu | Aviyonik
12 | XT-60 Seri Bağlantı Soketi XT60 | 2 | 232,76 TL | Promodel | 7-10 iş günü | https://www.promodelhobby.com/urun/xt-60-seri-baglanti-soketi-xt60 | Aviyonik
13 | XT60 Soket (XT60 Konnektör Dişi-Erkek Set) XT-60 | 6 | 46,18 TL | Promodel | 7-10 iş günü | https://www.promodelhobby.com/urun/xt60-soket-xt60-konnektor-disi-erkek-set-xt-60 | Aviyonik
14 | Lipo Saklama Çantası - 23x30 cm | 2 | 506,10 TL | Robotistan | 7-10 iş günü | https://www.robotistan.com/lipo-saklama-cantasi-21x28cm | Aviyonik
TOPLAM |  |  | 44.298,21 TL
1 | iğne vana | 2 | 30000 ? TL | meltas | 2-4-6 hafta | - | pnömatik | 2 farklı ürün bakılmakta ürünler için proformalar istendi fiyat bilgisi şu an kesin olarak yok tedarikçide kesin olarak belli değil en uygun teklifi hangisi yaparsa
2 | Motor+redüktör | 1 | 360 dolar | made in china | 7-12 iş günü | https://jkongmotor.en.made-in-china.com/product/oZOTCHucQkVS/China-NEMA-34-Stepper-Motor-with-90degree-Planetary-Gear-Reducer-Right-Angle-Gearbox.html | pnömatik | ürün bir çok parametre barındırıyor alım yapılırken daha teknik açıklama yapılacaktır fiyatı 12.06.2023 göre
3 | Haç rakor | 1 | 948 TL | HİDROERFLEX | 7-12 iş günü | https://www.hidroerflex.com/ | pnömatik | https://drive.google.com/file/d/1NlZnoPSNdFxe9KHbmOEXNO8EiZjAYHSM/view?usp=sharing
4 | Perde Nipel | 2 | 600 TL | HİDROERFLEX | 7-12 iş günü | https://www.hidroerflex.com/ | pnömatik | https://drive.google.com/file/d/1NlZnoPSNdFxe9KHbmOEXNO8EiZjAYHSM/view?usp=sharing
TOPLAM |  |  | 48307.19
1 | Karbonfiber Boru 1 | 12*2m | 35.381,12 TL | Kompozitnet |  | https://www.kompozit.net/karbon-fiber-boru-3k-dis-ic-cap-24mm-22mm | mekanik
2 | Karbonfiber Boru 2 | 12*1m | 10.109,34 TL | Kompozitshop |  | https://www.kompozitshop.com/karbon-fiber-boru-3k-disic-cap12mm10mm | mekanik
3 | Epoksi (A+B) | 2 | 2.600 TL | Epoksimarket |  | https://epoksimarket.com/sektorler/kompozit-uygulamalari/norm-hard-1500?utm_source=chatgpt.com | mekanik
4 | Kauçuk | 8 | Teklif İstenecek | Şahin Kauçuk |  | https://www.sahinkaucuk.com/urun/kare-takoz-ped-cesitleri | mekanik
5 | Rulman | 8 | 900,8 TL | Hepsiburada |  | https://www.hepsiburada.com/ors-6000-zz-c3-rulman-10x26x8-p-HBV00000D51WE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 | mekanik
6 | M10 Gijon | 20 | 704 TL | Hırdavatım |  | https://www.hirdavatim.com.tr/kategori/galvaniz-kapli-gijon | mekanik
7 | İnce Kauçuk | 4 | 471 TL | Endüstri Malzemesi |  | https://www.endustrimalzemesi.com/marka/diger-1 | mekanik
8 | Alüminyum Kütük | 70mm*1.5 metre | 7166 TL | Metal Reyonu |  | https://metalreyonu.com.tr/urun/aluminyum-cubuk-cap-70-mm | mekanik
TOPLAM |  |  | 57.332,26 TL
GENEL MALİYET |  |  | 149937.66
