Hushbee5/cold-gas-vertical-landing-rocket/(commit log)

2026-10-17 Cold-gas vertical landing rocket: models, HIL, firmware, data and technical summary
    Simulink/Simscape 6-DOF and NDI models, HIL loop and plant, ESP32-S3 firmware, flight and HIL logs, thrust tables, analysis scripts, figures and a technical summary with the main equations and results.
    [bill_of_materials.xlsx, competition_flight_2026-09-17.csv, hil_hover_run002_detail.csv, hil_hover_run002_summary.csv, hil_landing_run001_detail.csv, hil_landing_run001_summary.csv, tethered_drop_2026-08-21.csv, thrust_time_tables.xlsx]
2026-10-18 Remove avionics board and pneumatic system content
